cleavinger/monster_2021/images/box_back.jpg

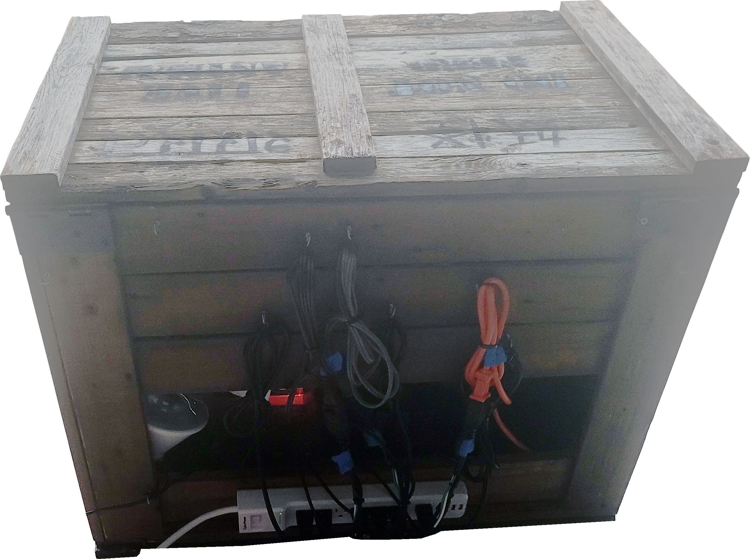
images/box_back.jpg
