cleavinger/monster_2021/images/box_front.jpg

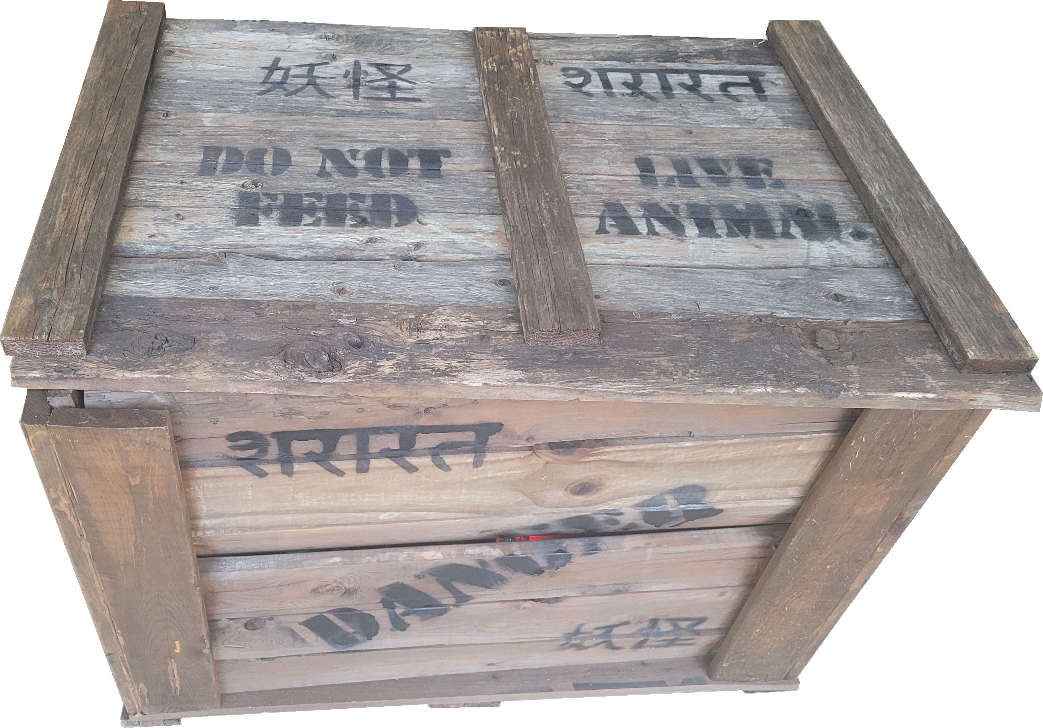
images/box_front.jpg
