cleavinger/monster_2021/images/box_left.jpg

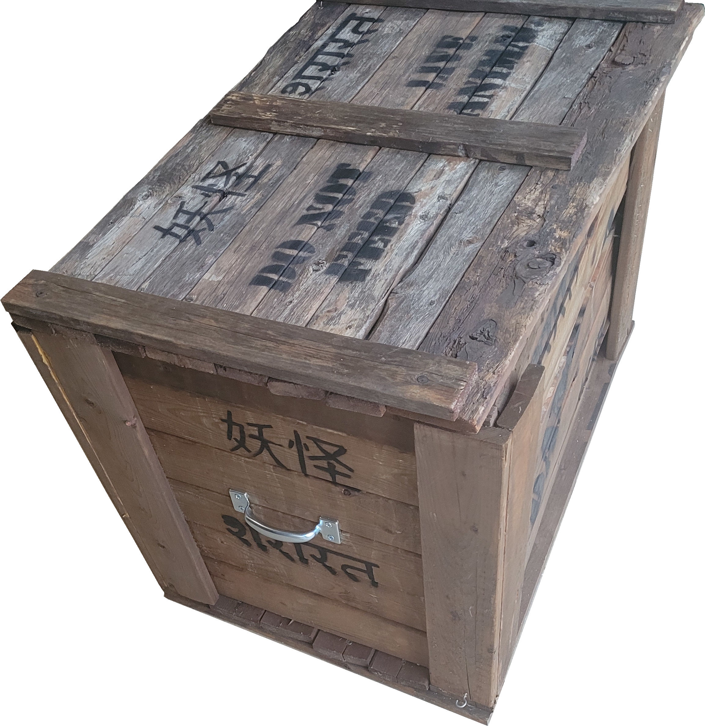
images/box_left.jpg
