cleavinger/monster_2021/images/box_right.jpg

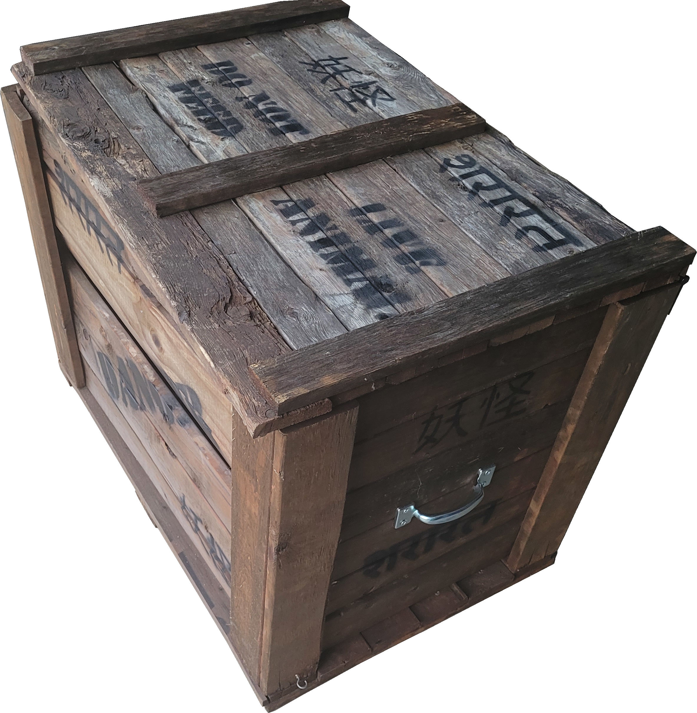
images/box_right.jpg
