cleavinger/monster_2021/images/chains2.jpg

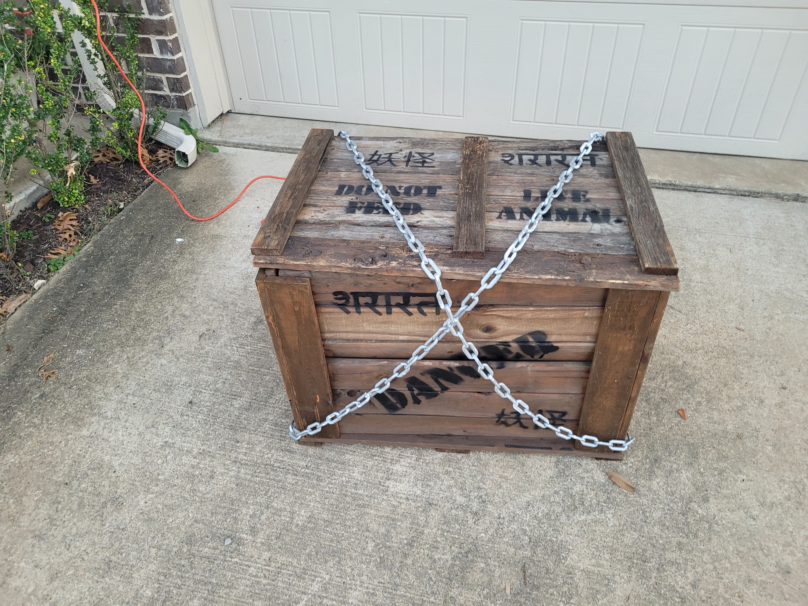
images/chains2.jpg
