cleavinger/monster_2021/images/front.jpg

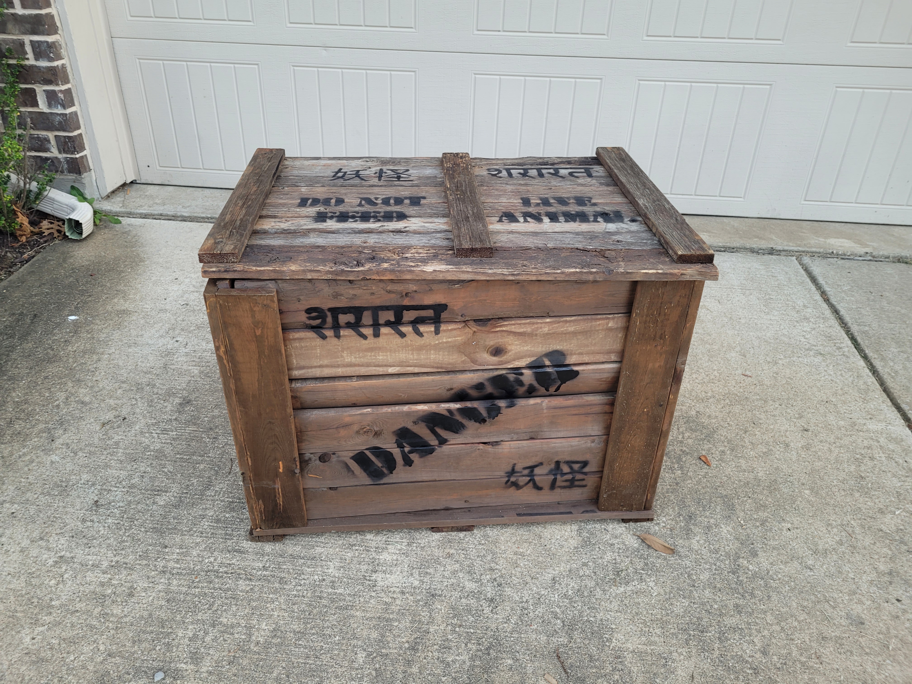
images/front.jpg
