cleavinger/monster_2021/images/left.jpg

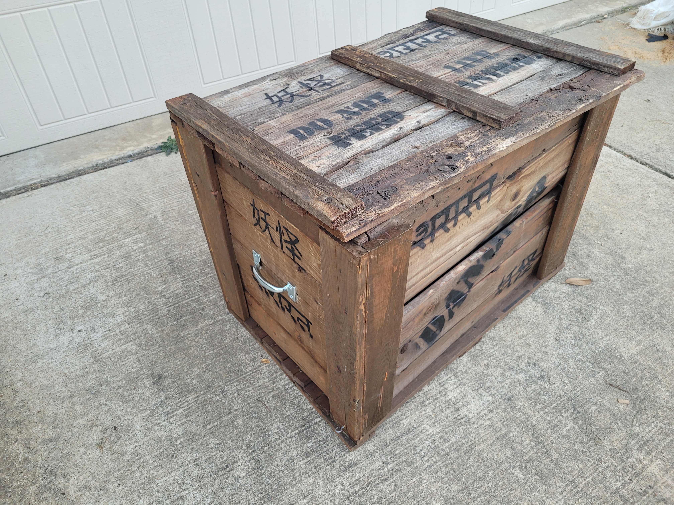
images/left.jpg
